CecileDest/RP1/Rapports de séance/rapport 7.pdf

Rapport Séance 7 le 21/02/2020 :

Aujourd’hui, j’ai essayé de rectifier la liaison entre la roue et la chifonie car le moteur n’étant pas exactement fixé au centre, lorsqu’elle tourne, la roue va en haut et en bas. Malheureusement même si elle le fait beaucoup moins, il reste une oscillation, je vais essayer d’y remédier pendant les vacances.

J’ai collé 4 petits triangles de bois de 5mm d’épaisseur à un niveau un peu en dessous de la roue (6cm du haut de l’instrument), pour poser la table d’harmonie dessus.

J’ai récupéré une plaque pour contrôler les solénoïdes. Je n’ai pas eu le temps pendant cette séance, mais pendant les vacances, je vais tester si chaque composant fonctionne correctement avec des leds, puis je testerai avec les solénoïdes.
