CecileDest/RP1/Rapports de séance/Séance 6.pdf

Séance 6 le 14/02/2020 :

Aujourd’hui j’ai monté la boite.

Tout d’abord, j’avais fait la boite assez haute pour avoir la place de mettre les solénoïdes et ce qui les tiendra. Mais mon moteur était trop bas sur son pied, donc j’ai fixé sous celui-ci un bout de bois de 1cm d’épaisseur.

J’ai ensuite vissé le moteur sur le socle de l’instrument par en-dessous.

J’ai percé le côté le plus proche du moteur pour faire passer les câbles de celui-ci.

Ensuite j’ai collé tous les cotés de la boite ensembles, en scotchant ceux-ci le temps que la colle sèche.

J’ai scié un rectangle dans la planche qui sert de table pour laisser passer la roue.

Enfin j’ai scié quatre petits carré de bois que je collerai à chaque coin de la boite pour poser la table dessus.
