CecileDest/RP1/Rapports de séance/rapport séance 5.pdf

Rapport séance 5 le 07/02/2020 :

J’ai poncé le socle du moteur car lorsque j’avais mal scié celui-ci, le dessus n’était pas plat, ce qui est problématique, le roue aurait été inclinée.

J’ai assemblé les trois disques pour faire la roue avec de la colle à bois, et en les mettant sous pression avec un poids et du scotch pour qu’ils soient bien alignés.

J’ai percé le centre de la roue mais pas dans toute sa profondeur pour que le moteur soit un petit peu enfoncé dans la roue. J’ai ensuite fixé le moteur avec des vis qui elles transpercent la roue et sont serrés avec des écrous.

J’ai récupéré une quinzaine de petits solénoïdes.

Eline et Enzo du groupe un m’ont expliqué comment connecter les solénoïdes avec les différents composants, comment les souder à une plaque.

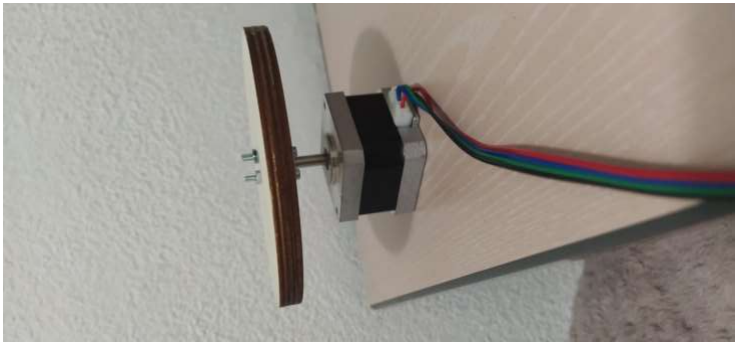
[picture p9: figure]
