CecileDest/RP1/Rapports de séance/rapport séance 2.pdf

Rapport séance 2 le 8/01/2020

Je pense utiliser un système d’ajustage de la position des electro-aimants pour jouer les notes, ce qui permettra de rendre plus justes les notes lors du placement des solénoïdes.

J’ai étudié la construction de la chifonie dans le but d’aller au FabLab vendredi après-midi. J’ai recherché des plans de constructions, trouvés notamment sur le site http://neuma.free.fr/chifonie/ . Sur ce site, le cheviller est arrondi mais je le ferai plus carré pour simplifier la construction. Aussi pour l’instant une seule corde est prévue donc je n’y ferai qu’un seul trou pour une cheville.

J’ai schématisé chaque pièce nécessaire avec leurs dimensions sur la photo ci-dessous.

Pour relier le moteur et la roue j’utiliserai le petit disque de métal fixable sur la roue.

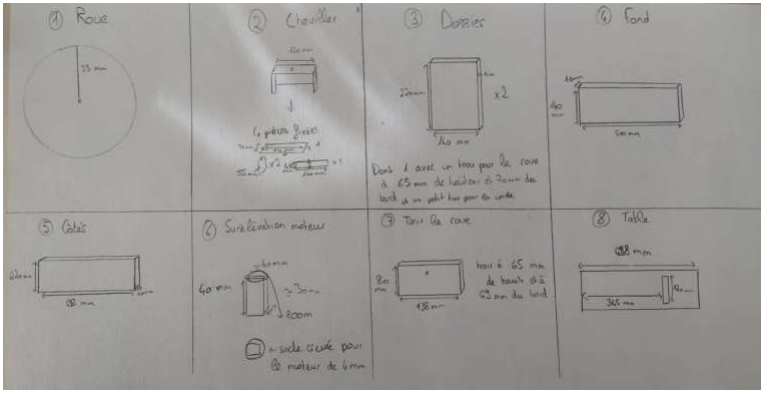
[picture p11: figure]
